davegutz/myVentilator/Vent_Photon/datasheets/schematic.jpg

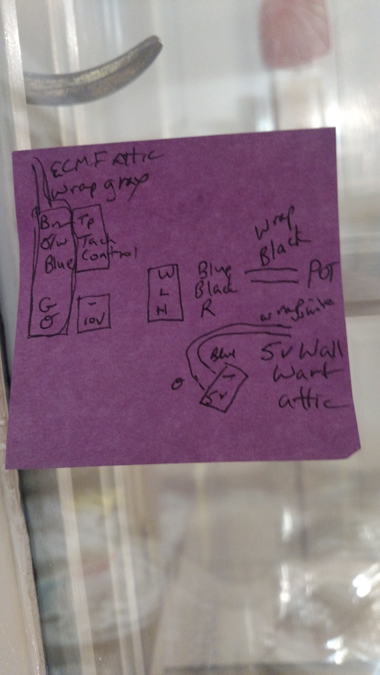
Vent_Photon/datasheets/schematic.jpg
