davegutz/myVentilator/Vent_Photon/dataReduction/vent_2021-02-22T03-46_open.png

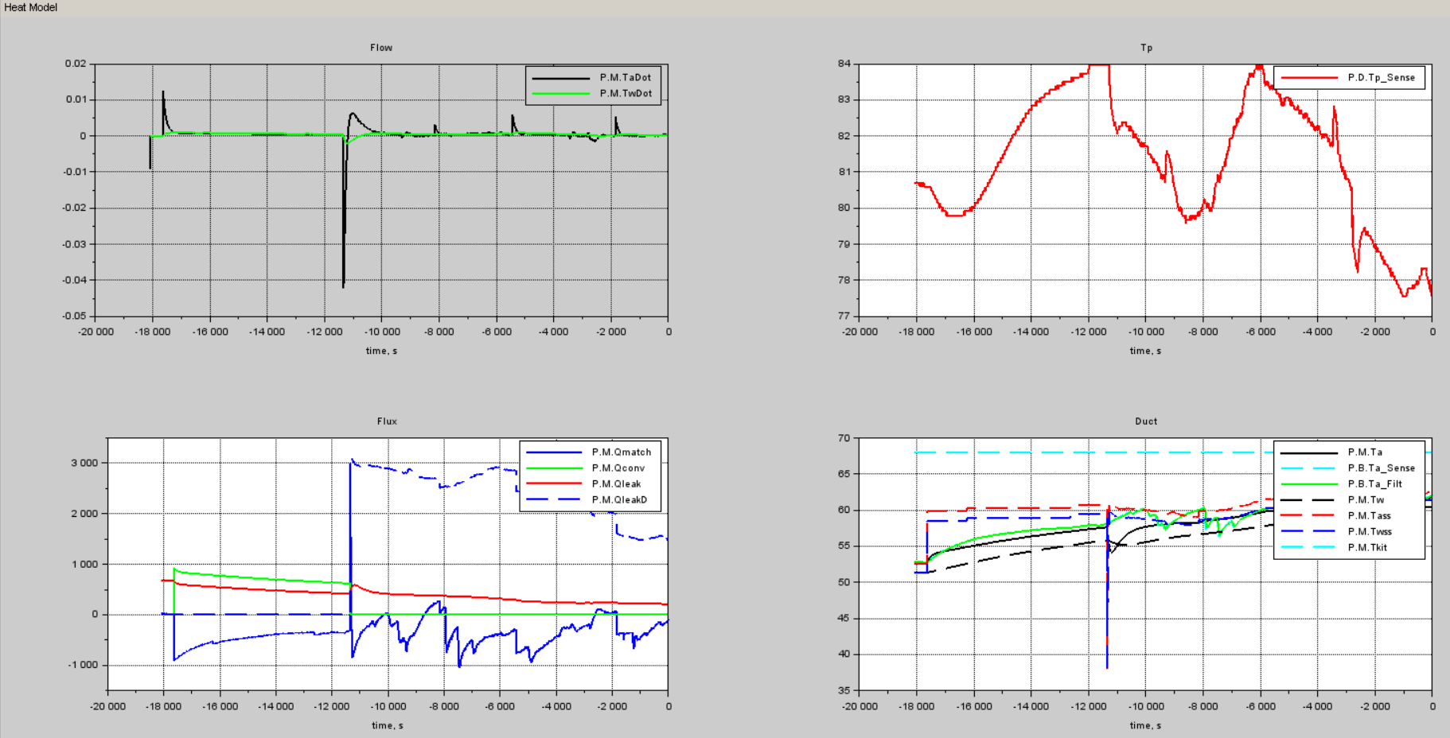
Vent_Photon/dataReduction/vent_2021-02-22T03-46_open.png
