davegutz/myVentilator/Vent_Photon/dataReduction/vent_2021-02-23T19-00_.png

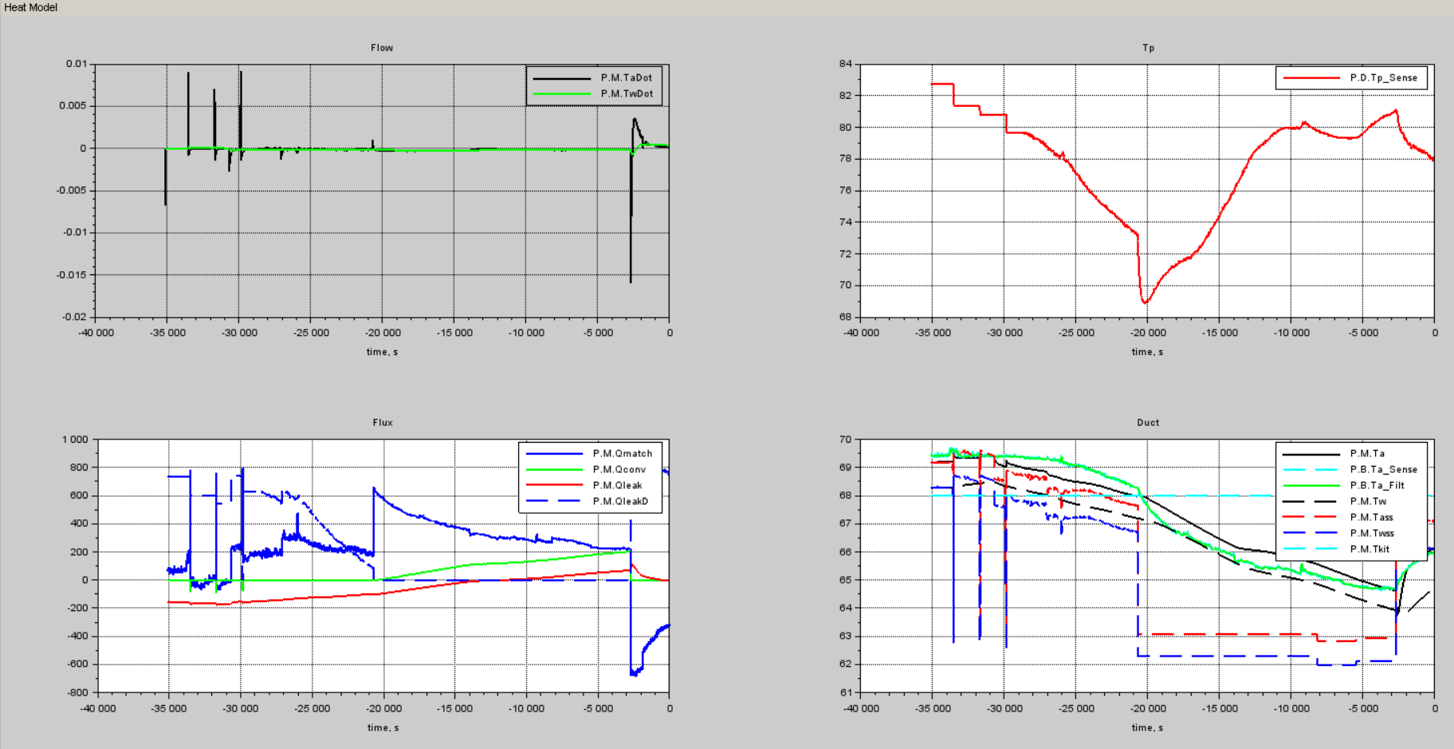
Vent_Photon/dataReduction/vent_2021-02-23T19-00_.png
