davegutz/myVentilator/Vent_Photon/dataReduction/vent_2021-03-02T04-31_.png

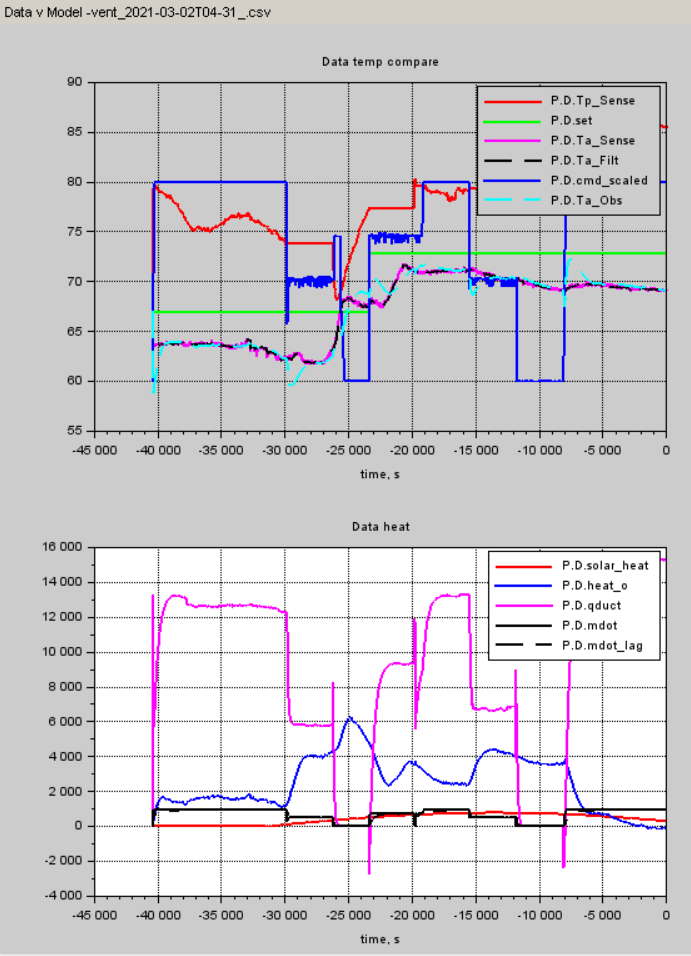
Vent_Photon/dataReduction/vent_2021-03-02T04-31_.png
