davegutz/myVentilator/Vent_Photon/datasheets/8_1000x.webp

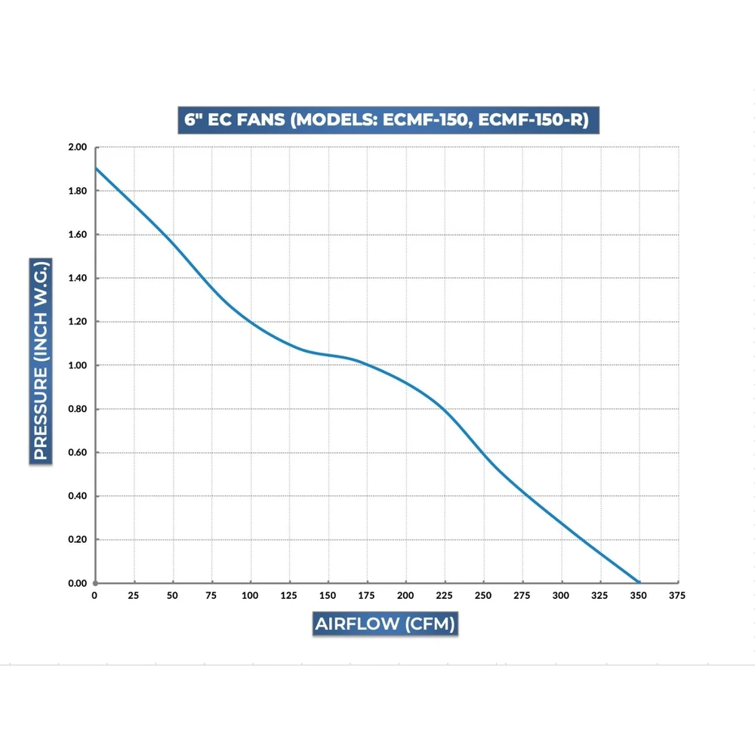
Vent_Photon/datasheets/8_1000x.webp
