davegutz/myVentilator/Vent_Photon/datasheets/friction-loss-thermaflex-mk-e-g-km-r-kd.jpg

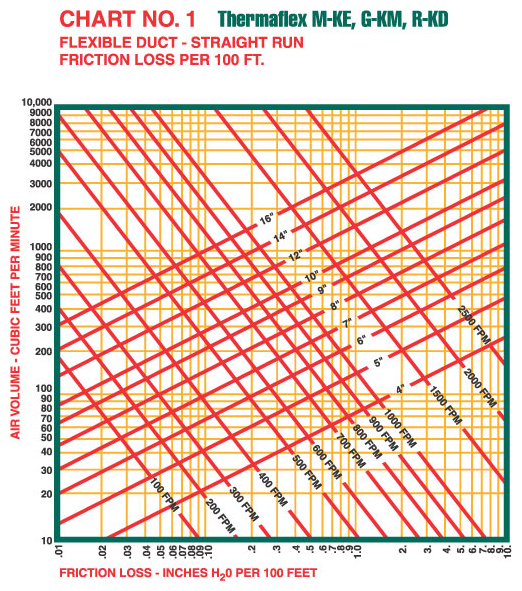
Vent_Photon/datasheets/friction-loss-thermaflex-mk-e-g-km-r-kd.jpg
