davegutz/myVentilator/Vent_Photon/LTspice/PCBA Specs 20191030-Model.pdf

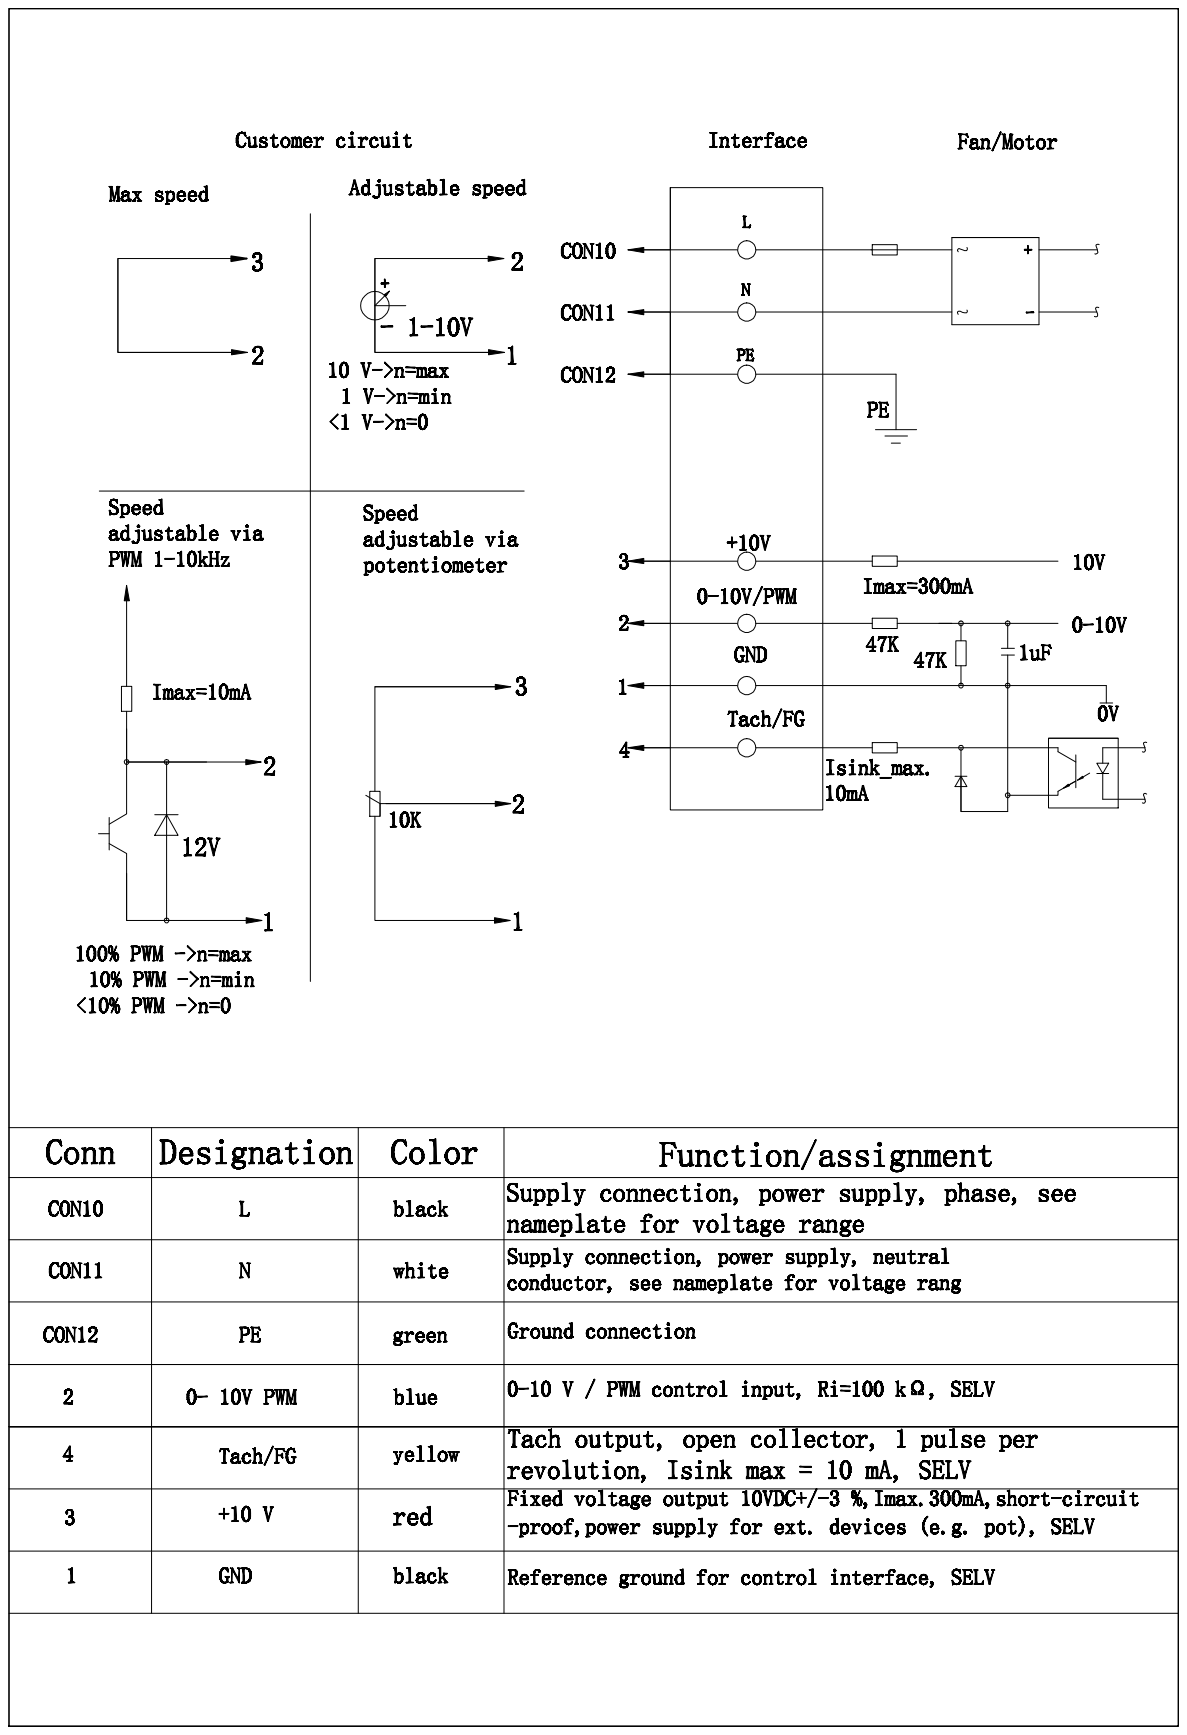
[picture p17: page 1]
