davegutz/myVentilator/Vent_Photon/LTspice/pwm_driver2.asc

C1: cap; 1µ
C2: cap; 1µ
C3: cap; 1µ
D1: diode; 1N4148
Q1: npn
Q2: npn; 2N2222
R1: res; 47k
R2: res; 4.7k
R3: res; 10k
R4: res; 47k
R5: res; 4.7k
R6: res; 10k
R7: res; 47,
R8: res; 47k
R9: res; 47k
R10: res; 47k
V1: voltage; PWL(0 1 0.1 1 0.100001 1k 0.2 1k 0.200001 1 0.5 1 0.500001 1k 0.6 1k 0.600001 1k 10 1k)
V2: voltage; PWL(0 10k 0.1 10k 0.100001 9k 0.2 9k 0.200001 10k 0.5 10k 0.500001 9k 0.6 9k 0.60001 9k 10 9k)
V3: voltage; PWL(0 5k 0.3 5k 0.300001 4k 0.4 4k 0.400001 5k 0.5 5k 0.500001 6k 0.6 6k 0.600001 5k 10 5k)
V4: voltage; PWL(0 5k 0.3 5k 0.300001 6k 0.4 6k 0.400001 5k 0.5 5k 0.500001 4k 0.6 4k 0.600001 5k 10 5k)
V5: voltage; PULSE(0 3.3 0 0 0 0.000001 0.00020)
V6: voltage; 10
Named nets: 0, POL, VDlow, VDhigh, VAhigh, VAlow, Vout, Vsense, VcNPN1, VcNPN2, Vsense2
.tran 0 0.25 0 .00001
300 mA max
