davegutz/myVentilator/Vent_Photon/LTspice/pot_switch.asc

C1: cap; 1µ
D1: diode; 1N4148
D7photon: voltage; PWL(0 0 0.05 0 0.05001 3.3 0.8 3.3 0.800001 0 10 0)
POHa: voltage; 10
Q1: npn; 2N2222
Q2: npn; 2N2222
R1: res; 47k
R2: res; 100k
R3: res; 300k; tol=5 pwr=.25
R4: res; 47k
R5: res; R=V(VDlow)
R6: res; R=V(VDhigh)
R7: res; R=V(VAlow)
R8: res; R=V(VAhigh)
V1: voltage; PWL(0 1 0.1 1 0.100001 1k 0.2 1k 0.200001 1 0.5 1 0.500001 1k 0.6 1k 0.600001 1k 10 1k)
V2: voltage; PWL(0 10k 0.1 10k 0.100001 9k 0.2 9k 0.200001 10k 0.5 10k 0.500001 9k 0.6 9k 0.60001 9k 10 9k)
V3: voltage; PWL(0 5k 0.3 5k 0.300001 4k 0.4 4k 0.400001 5k 0.5 5k 0.500001 6k 0.6 6k 0.600001 5k 10 5k)
V4: voltage; PWL(0 5k 0.3 5k 0.300001 6k 0.4 6k 0.400001 5k 0.5 5k 0.500001 4k 0.6 4k 0.600001 5k 10 5k)
Named nets: 0, POW, POL, POLa, VDlow, VDhigh, VAhigh, VAlow
.tran 0 0.9 0 .00001
