davegutz/myVentilator/Vent_Photon/src/mySubs.cpp

//
// MIT License
//
// Copyright (C) 2023 - Dave Gutz
//
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
#ifndef ARDUINO
#include "application.h" // Should not be needed if file .ino or Arduino
#endif
#include "mySubs.h"
#include "local_config.h"
#include "constants.h"
#include <math.h>

extern const int8_t debug;
extern Publish pubList;
extern char buffer[256];

// Check connection and publish Particle
void publish_particle(unsigned long now)
{
  sprintf(buffer, "%s,%s,%18.3f,   %4.1f,%4.1f,%7.3f,%7.3f,%5.1f,   %5.2f,%4.1f,%7.3f,  %7.3f,%7.3f,%7.3f,%7.3f,\
  %7.3f,%ld, %7.3f, %7.1f, %7.1f, %7.1f, %7.3f, %7.3f, %c", \
    pubList.unit.c_str(), pubList.hmString.c_str(), pubList.controlTime, pubList.lim, pubList.set-HYST, pubList.Tp,
    pubList.Ta, pubList.cmd, pubList.T, pubList.OAT, pubList.Ta_obs, pubList.err, pubList.prop,
    pubList.integ, pubList.cont, pubList.pcnt_pot, pubList.duty, pubList.Ta_filt, pubList.solar_heat, pubList.heat_o,
    pubList.qduct, pubList.mdot, pubList.mdot_lag, '\0');
  
  if ( debug>2 ) Serial.println(buffer);
  if ( Particle.connected() )
  {
    if ( debug>2 ) Serial.printf("Particle write\n");
    unsigned nowSec = now/1000UL;
    unsigned sec = nowSec%60;
    unsigned min = (nowSec%3600)/60;
    unsigned hours = (nowSec%86400)/3600;
    char publishString[40];     // For uptime recording
    sprintf(publishString,"%u:%u:%u",hours,min,sec);
    Particle.publish("Uptime",publishString);
    Particle.publish("stat", buffer);
    if ( debug>2 ) Serial.println(buffer);
  }
  else
  {
    if ( debug>1 ) Serial.printf("Particle not connected....connecting\n");
    Particle.connect();
    pubList.numTimeouts++;
  }
}

// Text header
void print_serial_header(void)
{
  Serial.println(F("unit,hm, cTime, lim,set,Tp,Ta,cmd,  T,OAT,Ta_o,  err,prop,integ,cont,  pcnt_pot,duty,Ta_filt,  solar,  heat_o, qduct, mdot, mdot_lag,"));
}

// Inputs serial print
void serial_print_inputs(unsigned long now, double T)
{
  sprintf(buffer, "%s,%s,%18.3f,   %4.1f,%4.1f,%7.3f,%7.3f,%5.1f,   %5.2f,%4.1f,%7.3f,  %7.3f,%7.3f,%7.3f,%7.3f,\
  %7.3f,%ld, %7.3f, %7.1f, %7.1f, %7.1f, %7.3f, %7.3f, %c", \
    pubList.unit.c_str(), pubList.hmString.c_str(), pubList.controlTime, pubList.lim, pubList.set-HYST, pubList.Tp,
    pubList.Ta, pubList.cmd, pubList.T, pubList.OAT, pubList.Ta_obs, pubList.err, pubList.prop,
    pubList.integ, pubList.cont, pubList.pcnt_pot, pubList.duty, pubList.Ta_filt, pubList.solar_heat, pubList.heat_o, 
    pubList.qduct, pubList.mdot, pubList.mdot_lag, '\0');
  Serial.println(buffer);
}

// Normal serial print
void serial_print(double cmd)
{
  if ( debug>2 )
  {
    Serial.print(cmd, 2); Serial.print(F(", "));
    Serial.print(pubList.duty, DEC); Serial.print(F(", "));
    Serial.println("");
  }
}


// Load and filter
// TODO:   move 'read' stuff here
boolean load(int reset, double T, Sensors *sen, Control *con, DuctTherm *duct, RoomTherm *room,
    General2_Pole* TaSenseFilt, Insolation *sun_wall, DS18 *sensor_plenum, Pins *myPins)
{
  static boolean done_testing = false;

  // Read Sensor
  if ( !bare )
  {
    // Honeywell Read
    Wire.beginTransmission(TA_SENSOR);
    Wire.endTransmission();
    delay(40);
    Wire.requestFrom(TA_SENSOR, 4);
    Wire.write(byte(0));
    uint8_t b = Wire.read();
    sen->I2C_status = b >> 6;

    // Honeywell conversion
    int rawHum  = (b << 8) & 0x3f00;
    rawHum |=Wire.read();
    sen->hum = roundf(rawHum / 163.83) + (HW_HUMCAL);
    int rawTemp = (Wire.read() << 6) & 0x3fc0;
    rawTemp |=Wire.read() >> 2;
    sen->Ta = (float(rawTemp)*165.0/16383.0 - 40.0)*1.8 + 32.0 + (TA_TEMPCAL); // convert to fahrenheit and calibrate

    // Model
    duct->update(reset, T, sen->Tp,  con->duty, sen->OAT);
    room->update(reset, T, duct->Qduct(), duct->mdot(), duct->mdot_lag(), M_TK, sen->OAT,
      (con->heat_o + sun_wall->solar_heat()), sen->Ta);
    sen->Ta_obs = room->Ta();
    sen->qduct = duct->Qduct();
    sen->mdot = duct->mdot();
    sen->mdot_lag = duct->mdot_lag();

    // MAXIM conversion 1-wire Tp plenum temperature
    if ( sensor_plenum->read() ) sen->Tp = sensor_plenum->fahrenheit() + (TP_TEMPCAL);

    // Pot input
    int raw_pot_trim = analogRead(myPins->pot_trim);
    int raw_pot_control = analogRead(myPins->pot_control);
    sen->pcnt_pot = min(max(double(raw_pot_trim)/40.96*1.1, double(raw_pot_control)/40.96*1.6), 100);

    // Tach input
    int raw_tach = analogRead(myPins->tach_sense);
    sen->pcnt_tach = double(raw_tach)/40.96;
  }
  else
  {
    // Pots
    int raw_pot_control = analogRead(myPins->pot_control);
    sen->Tp =  double(raw_pot_control)/4096. * 10 + 70;
    sen->pcnt_pot = 100.;

    // Model
    duct->update(reset, T, sen->Tp,  con->duty, sen->OAT);
    room->update(reset, T, duct->Qduct(), duct->mdot(), duct->mdot_lag(), M_TK, sen->OAT,
        (con->heat_o+sun_wall->solar_heat()), con->set);
    sen->Ta_obs = room->Ta();
    sen->Ta = room->Ta();
    sen->qduct = duct->Qduct();
    sen->mdot = duct->mdot();
    sen->mdot_lag = duct->mdot_lag();
  }
  sen->Ta_filt = TaSenseFilt->calculate( sen->Ta, reset, T);

  // Built-in-test logic.   Run until finger detected
  if ( true && !done_testing )
  {
    done_testing = true;
  }
  else                    // Possible finger detected
  {
    done_testing = false;
  }

  // Built-in-test signal replaces sensor
  if ( !done_testing )
  {
  }

  return ( !done_testing );
}

// Write to the D/A converter
uint32_t pwm_write(uint32_t duty, Pins *myPins)
{
    analogWrite(myPins->pwm_pin, duty, pwm_frequency);
    return duty;
}

// Returns any text found between a start and end string inside 'str'
// example: startfooend  -> returns foo
String tryExtractString(String str, const char* start, const char* end)
{
  if (str == "")
  {
    return "";
  }
  int idx = str.indexOf(start);
  if (idx < 0)
  {
    return "";
  }
  int endIdx = str.indexOf(end);
  if (endIdx < 0)
  {
    return "";
  }
  return str.substring(idx + strlen(start), endIdx);
}


// Convert time to decimal for easy lookup
double decimalTime(unsigned long *currentTime, char* tempStr)
{
    Time.zone(GMT);
    *currentTime = Time.now();
    uint32_t year = Time.year(*currentTime);
    uint8_t month = Time.month(*currentTime);
    uint8_t day = Time.day(*currentTime);
    uint8_t hours = Time.hour(*currentTime);

    // Second Sunday Mar and First Sunday Nov; 2:00 am; crude DST handling
    if ( USE_DST)
    {
      uint8_t dayOfWeek = Time.weekday(*currentTime);     // 1-7
      if (  month>2   && month<12 &&
        !(month==3  && ((day-dayOfWeek)<7 ) && hours>1) &&  // <second Sunday Mar
        !(month==11 && ((day-dayOfWeek)>=0) && hours>0) )  // >=first Sunday Nov
        {
          Time.zone(GMT+1);
          *currentTime = Time.now();
        }
    }
    #ifndef FAKETIME
        uint8_t dayOfWeek = Time.weekday(*currentTime)-1;  // 0-6
        uint8_t minutes   = Time.minute(*currentTime);
        uint8_t seconds   = Time.second(*currentTime);
        if ( debug>5 ) Serial.printf("DAY %u HOURS %u\n", dayOfWeek, hours);
    #else
        // Rapid time passage simulation to test schedule functions
        uint8_t dayOfWeek = (Time.weekday(*currentTime)-1)*7/6;// minutes = days
        uint8_t hours     = Time.hour(*currentTime)*24/60; // seconds = hours
        uint8_t minutes   = 0; // forget minutes
        uint8_t seconds   = 0; // forget seconds
    #endif
    sprintf(tempStr, "%4u-%02u-%02uT%02u:%02u:%02u", int(year), month, day, hours, minutes, seconds);
    return (((( (float(year-2021)*12 + float(month))*30.4375 + float(day))*24.0 + float(hours))*60.0 + float(minutes))*60.0 + \
                        float(seconds));
}


// Process a new temperature setting
int setSaveDisplayTemp(float lim, double t, Sensors *sen, Control *con)
{
    con->set = t;
    con->lim = lim;
    return con->set;
}
