davegutz/myVentilator/Vent_Photon/src/local_config.h

#ifndef local_config_h
#define local_config_h

const   String    unit = "vent";
// const   String    unit = "proto";
// #define BARE                  // Run without peripherals, except maybe a POT

#endif
