davegutz/myVentilator/(commit log)

2021-01-09 add honeywell sensor
2021-01-09 Add Maxim 1-wire
2021-01-15 initial prototype pwm
2021-01-15 first working PWM
2021-01-21 first data
    [CoolTerm Capture 2021-01-20 13-00-00.csv]
2021-01-21 time constants
    [CoolTerm Capture 2021-01-20 13-00-00_floor.xlsx, CoolTerm Capture 2021-01-20 14-55-58.csv]
2021-01-22 step test doc
    [CoolTerm Capture 2021-01-21 14-12-19.xlsx]
2021-01-25 new board
2021-01-25 Update CoolTerm Capture 2021-01-21 14-12-19.xlsx
    [CoolTerm Capture 2021-01-21 14-12-19.xlsx]
2021-02-01 scilab plots
    [airflow model.xlsx, debug.csv, doubtf.csv]
2021-02-02 tune DB
    [CoolTerm Capture 2021-01-21 14-12-19.xlsx]
2021-02-02 begin work on model
    [airflow model.xlsx]
2021-02-03 heat model
    [airflow model.xlsx]
2021-02-04 initial total_model
    [airflow model.xlsx, largeStepDecr_2021_02_04.csv]
2021-02-06 fix plotter
    [CoolTerm Capture 2021-01-20 13-00-00.csv, CoolTerm Capture 2021-01-20 14-55-58.csv, CoolTerm Capture 2021-01-21 07-30-23.csv, CoolTerm Capture 2021-01-21 14-12-19.csv, debug.csv]
2021-02-07 touch up
    [CoolTerm Capture 2021-01-21 14-12-19.xlsx]
2021-02-10 proto with filter
2021-02-14 sky model
    [vent_2021-02-01T22-44.csv, vent_2021-02-05T17-00.csv, vent_2021-02-06T14-00.csv]
2021-02-28 tune heat model done
    [doubtf.csv]
2022-11-22 Create pwm_driver2.asc
    verify proper operation parallel ECMF. Yes, OK
2023-01-04 get it running again
    [debug.csv]
2023-01-04 update delete Blynk
    [debug.csv]
2023-01-05 new dual mode using pot
    [debug.csv]
2023-01-05 Scale for 2 fans
    [debug.csv]
2023-01-05 Pot over-ride
    [debug.csv]
2023-01-05 fix scilab
    [debug.csv, doubtf.csv]
