davegutz/myVentilator/Vent_Photon/datasheets/PLC board.jpg

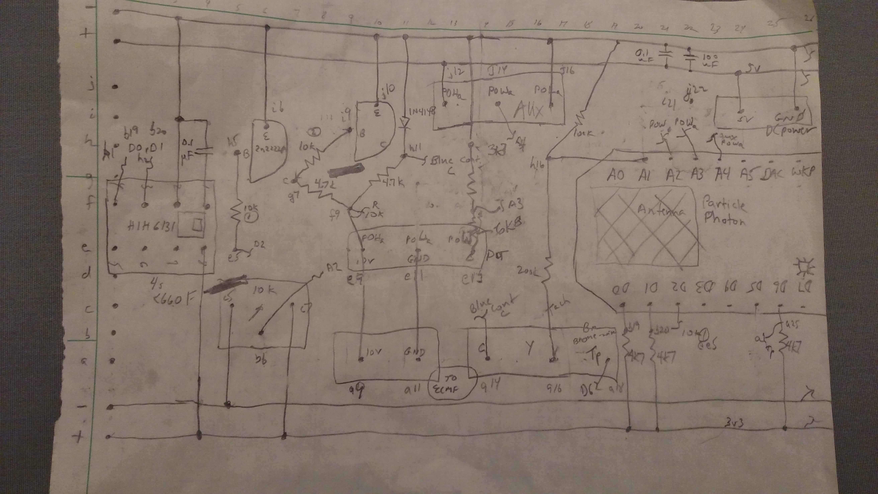
Vent_Photon/datasheets/PLC board.jpg
